euudiay/electrolites/report/acknowledgements.tex

% \chapter{}
% \label{sec:acknowledgements}
	
	% Los agradecimientos que vayamos a hacer
	\cleardoublepage
	\null\vspace{\stretch{1}}
	\begin{flushright}
		\emph{To Carlos, for his mad soldering skills and wise guidance,\\
		to Fran because of his healthy support,\\
		and very special thanks to everyone that has been there,\\
		bearing with us.}
	\end{flushright}
	\vspace{\stretch{3}}\null
