euudiay/electrolites/report/cover.tex

\thispagestyle{empty}

\begin{center}
	{\LARGE \textbf{\thetitle}}\\
	\vspace{0.5cm}
	% {\LARGE Sistema de monitorización ECG de bajo consumo para dispositivos móviles}\\
	{\Large Sistema inalámbrico de bajo consumo para monitorización de electrocardiogramas desde dispositivos Android}

	\vspace{1cm}
	{\large
		Pablo Fernández Vicente\\
		Rafael Basilio de la Hoz Sevilla\\
		\vspace{1.5mm}
		\hspace{1mm}Miguel Márquez Altuna
	}

	\vspace{1cm}
	% PROYECTO DE SISTEMAS INFORMÁTICOS\\
	% FACULTAD DE INFORMÁTICA\\
	Proyecto de Sistemas Informáticos, 
	Facultad de Informática\\
	Universidad Complutense de Madrid
	\vspace{1cm}

	\\
	\vspace{.5cm}
	% Department of Computer Architecture and Automation\\
	Departamento de Arquitectura de Computadores y Automática\\
	Curso 2011/2012
\end{center}

\begin{flushright}
	Directores:\\
	Luis Piñuel Moreno\\
	Joaquín Recas Piorno\\
\end{flushright}
