euudiay/electrolites/report/figs/mlts-arch-usb.pdf

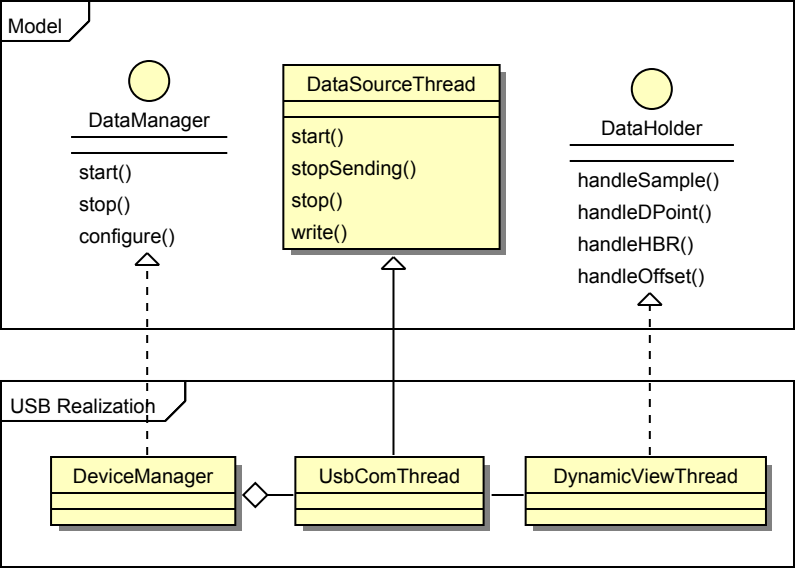
[picture p5: figure]
USBCRealization; Model; DataManager; start() stop() configure(); DataHolder; handleSample() handleDPoint() handleHBR() handleOffset(); DeviceManager; UsbComThread; DataSourceThread; start() stopSending() stop() write(); DynamicViewThread
