euudiay/electrolites/report/bibliography.tex

\begin{thebibliography}{widest-label}

\bibitem{ESL}
 	\emph{Real-Time Wavelet-Based Electrocardiogram Delineation System with Automatic Arrhythmia Detection}\\
 	Embedded Systems Laboratory, ESL\\
 	École Polytechnique Fédérale de Lausanne, EPFL\\
 	\url{http://esl.epfl.ch/cms/lang/en/pid/46016}\\
	
\bibitem{androidSpread}
	\emph{Google’s Android becomes the world’s leading smart phone platform}\\
	Canalys\\
	January 31, 2011\\
	\url{http://www.canalys.com/static/press_release/2011/r2011013.pdf}

\bibitem{sphoneStudy}
	\emph{The all-conquering smartphone seems headed for ubiquity}\\
	Gizmag\\
	September 5, 2011\\
	\url{http://www.gizmag.com/smartphone-sales/19723/}
	
\bibitem{andDev-what}
	\emph{What is Android}\\
	Android Developers\\
	\url{http://developer.android.com/guide/basics/what-is-android.html}

\bibitem{andDev-sdk}
	\emph{Android SDK}\\
	Android Developers\\
	\url{http://developer.android.com/sdk/index.html}
	
\bibitem{iosDev}
	\emph{Program Enrollment}\\
	iOS Developer Program\\
	\url{https://developer.apple.com/support/ios/enrollment.html#systemrequirements}
	
\bibitem{ecg.del.paper}
	\emph{Development and Evaluation of Multilead Wavelet-Based ECG Delineation Algorithms for Embedded Wireless
		Sensor Nodes}\\
	F. Rincón, J. Recas, N. Khaled, D. Atienza\\
	IEEE Transactions On Information Technology In Biomedicine, Vol. 15, No. 6, p. 854-863\\
	November, 2011
	
\bibitem{and-zigbee}
	\emph{Android ZigBee Interface}\\
	Texas Instruments\\
	\url{http://processors.wiki.ti.com/index.php/Android_ZigBee_Interface}
	
\bibitem{who-cvd}
	\emph{Cardiovascular diseases (CVDs)}\\
	World Health Organization\\
	\url{http://www.who.int/mediacentre/factsheets/fs317/en/index.html}
	
\bibitem{AppleJB}
	\emph{Unauthorized modification of iOS as a major source of instability, disruption of services, and other issues}\\
	Apple Support\\
	September 27, 2010\\
	\url{http://support.apple.com/kb/ht3743}
	
\bibitem{802.15.4}
	\emph{IEEE Std 802.15.4\texttrademark-2006}\\
	(Revision of IEEE Std 802.15.4-2003)\\
	Institute of Electrical and Electronics Engineers\\
	June 7, 2006
	
\bibitem{ADK}
	\emph{Android Open Accessory Development Kit}\\
	Android Developers\\
	\url{http://developer.android.com/guide/topics/usb/adk.html}
	
\bibitem{GoogleIO}
	\emph{Android Open Accessory API and Development Kit (ADK)}\\
	Mike Lockwood, Erik Gilling \& Jeff Brown\\
	May 10, 2011\\
	\url{http://www.google.com/events/io/2011/sessions/android-open-accessory-api-and-development-kit-adk.html}
	
\bibitem{dongle}
	\emph{IEEE 802.15.4/ZigBee\texttrademark USB Dongle}\\
	Integration, Adaptive Modules\\
	\url{http://www.adaptivemodules.com/assets/File/integration_802-15-4_usb\%20dongle.pdf}	

\bibitem{articleTI}
	\emph{TI presents World’s first platform bringing ZigBee to Android smartphones and tablets}.\\
 	Texas Instruments\\
	March 04, 2011\\
 	\url{http://www.ti.com/ww/in/news_detail/2011/news_detail_20110304.html}\\
 	
\bibitem{mbed}
	\emph{mbed: Rapid Prototyping with Microcontrollers}\\
	ARM Holdings\\
	\url{http://mbed.org/}
	
\bibitem{msp430}
	\emph{TI MSP430. Getting started}\\
	Texas Instruments\\
	\url{http://www.ti.com/lsds/ti/microcontroller/16-bit_msp430/getting_started.page}
	
\bibitem{msp430iss}
	\emph{MSP430 Family Instruction Set Summary}\\
	Texas Instruments\\
	\url{http://www.ti.com/sc/docs/products/micro/msp430/userguid/as_5.pdf}
	
\bibitem{5438a}
	\emph{MSP430F543xA, MSP430F541xA Mixed Signal Microcontroller Datasheet}\\
	Texas Instruments\\
	\url{http://www.ti.com/lit/ds/symlink/msp430f5438a.pdf}
	
\bibitem{msp430f6638ds}
	\emph{MSP430F663x Family Mixed Signal Microcontroller Datasheet}\\
	Texas Instruments\\
	\url{http://www.ti.com/lit/ds/symlink/msp430f6638.pdf}

\bibitem{5438aboard}
	\emph{MSP - EXP430F5438}\\
	Texas Instruments\\
	\url{http://www.ti.com/tool/msp-exp430f5438}

\bibitem{6638board}
	\emph{MSP - TS430PZ100USB}\\
	Texas Instruments\\
	\url{http://www.ti.com/tool/msp-ts430pz100usb}

\bibitem{Shimmer}
	\emph{Shimmer Platform - Key Features}\\
	Shimmer Research\\
	\url{http://www.shimmer-research.com/r-d/platform-features}

\bibitem{ShimmerExp}
	\emph{Shimmer Expansion Modules}\\
	Shimmer Research\\
	\url{http://www.shimmer-research.com/r-d/hardware/extension-modules}

\bibitem{usbhost}
	\emph{USB Host and Accessory}\\
	Android Developers\\
	\url{http://developer.android.com/guide/topics/usb/index.html}
	
\bibitem{TIUSB}
	\emph{MSP430 USB Developers Package}\\
	Texas Instruments\\
	\url{http://www.ti.com/tool/msp430usbdevpack}
	
\bibitem{xoomspecs}
	\emph{Motorola XOOM™ Fact Sheet}\\
	Motorola\\
	\url{http://mediacenter.motorola.com/Fact-Sheets/Motorola-XOOM-Fact-Sheet-3537.aspx}

\bibitem{andev-activity}
	\emph{Activities}\\
	Android Developers\\
	\url{http://developer.android.com/guide/topics/fundamentals/activities.html}
	
\bibitem{andev-view}
	\emph{View}\\
	Android Developers\\
	\url{http://developer.android.com/reference/android/view/View.html}

\bibitem{solarflight}
	\emph{Solar Impulse}\\
	\url{http://solarimpulse.com/}

\end{thebibliography}
