euudiay/electrolites/report/electrolites.tex

\documentclass[11pt,a4paper,openright]{book}
\usepackage{graphicx}
\usepackage[spanish, english]{babel}
\usepackage[utf8]{inputenc}
\usepackage[nottoc]{tocbibind}
\usepackage{appendix}
\usepackage[breaklinks,backref=true,colorlinks=true]{hyperref}
\usepackage{fancyhdr}
\usepackage{comment}
\usepackage{url}
\usepackage{todonotes}
\usepackage{wrapfig}
\usepackage{eurosans}
% \usepackage{layout}

\graphicspath{{figs/}}

\hyphenation{dis-po-si-ti-vo}
\hyphenation{dis-po-si-ti-vos}
\hyphenation{re-le-van-te}
\hyphenation{re-le-van-tes}

% Comandos para consultar la fecha y el título del documento
\newcommand{\thedate}{\today}
% \newcommand{\thetitle}{Electrolites}
\newcommand{\thetitle}{Low-power Wireless ECG Monitoring System for Android Devices}

\setlength{\parindent}{0in}

\title{\thetitle}
\author{Pablo Fernández\\Rafael de la Hoz\\Miguel Márquez}

\hypersetup{backref=true, colorlinks=true, linkcolor=black, menucolor=black,
	urlcolor=black, citecolor=black}

\linespread{1.125}

\begin{document}

	% \layout

	% \maketitle
	\frontmatter % Para prólogos y abstracts y cosas así (numeración romana)
	\pagestyle{fancy}

	% \listoftodos
	
	% Redefinición del estilo plain para cambiar los inicios de capítulos
	\fancypagestyle{plain} {
		\fancyhf{}
		\fancyfoot[RO,LE]{\thepage}
		\renewcommand{\headrulewidth}{0.0pt}
		\renewcommand{\footrulewidth}{0.0pt}
	}

	% Sin encabezados ni pie de página, sólo la numeración de la página
	\pagestyle{plain}
	\fancyhf{}
	\fancyfoot[RO,LE]{\thepage}
	\renewcommand{\headrulewidth}{0.0pt}
	\renewcommand{\footrulewidth}{0.0pt}

	% Documentos anteriores al índice
	\input{cover}
	\input{abstract}
	\input{acknowledgements}

	\tableofcontents % Índice

	% Para la lista de figuras y la de tablas, lo mismo
	\pagestyle{plain}
	\fancyhf{}
	\fancyfoot[RO,LE]{\thepage}
	\renewcommand{\headrulewidth}{0.0pt}
	\renewcommand{\footrulewidth}{0.0pt}
	\listoffigures
	% \listoftables

	\input{spanish}

	% formato para encabezado/pie de pagina para el resto del documento
	\mainmatter % Para el resto del documento (numeración arábiga)
	\pagestyle{fancy}
	\renewcommand{\chaptermark}[1]{\markboth{#1}{}}	% Para que no nos lo escriba en mayúsculas
	\renewcommand{\sectionmark}[1]{\markright{#1}{}}	% Para que no nos lo escriba en mayúsculas
	\fancyfoot[RO,LE]{\thepage}					% Número de página en los bordes
	\fancyfoot[RE,LO]{{\it \thetitle}}				% Título del documento en el interior del pie de página
	\fancyhead[LE]{{\it \leftmark}}				% Sección (izquierda, pares)
	\fancyhead[RO]{{\it \rightmark}}				% Capítulo (derecha, impares)
	\fancyhead[RE]{}							% (derecha, pares)
	\fancyhead[LO]{}							% (izquierda, impares)
	\cfoot{}
	\renewcommand{\headrulewidth}{1.1pt}			% Grosor de la línea del encabezado
	\renewcommand{\footrulewidth}{1.1pt}			% Grosor de la línea del pie de página

	% Capítulos
	\input{intro}
	\input{hardware}
	\input{software}
	\input{results}

	% Anexos
	\begin{appendices}
		\renewcommand{\setthesection}{\Alph{section}}	% Numeramos con letras
		\appendix
		\appendixpage
		\input{engineering}
	\end{appendices}

	% Bibliografía
	\fancyhf{}
	\fancyfoot[RO,LE]{\thepage}
	\renewcommand{\headrulewidth}{0.0pt}
	\renewcommand{\footrulewidth}{0.0pt}
	\input{bibliography}

\end{document}
