euudiay/electrolites/report/figs/mlts-arch-bt.pdf

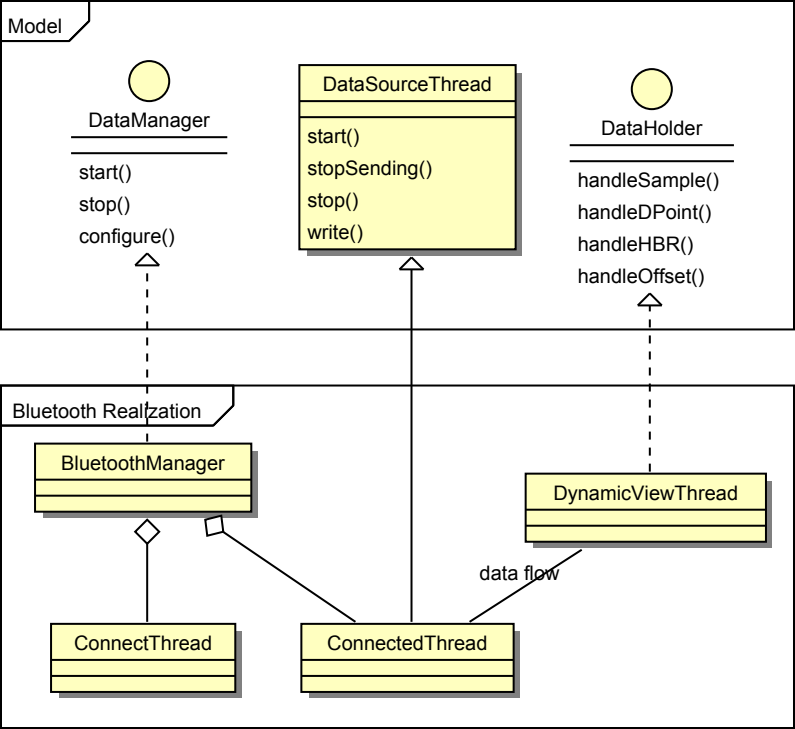
[picture p19: figure]
BluetoothwRealization; Model; ConnectThread; DataHolder; handleSample() handleDPoint() handleHBR() handleOffset(); ConnectedThread; DataSourceThread; start() stopSending() stop() write(); BluetoothManager; DataManager; start() stop() configure(); DynamicViewThread; datawflow
