euudiay/electrolites/report/figs/mlts-arch-log.pdf

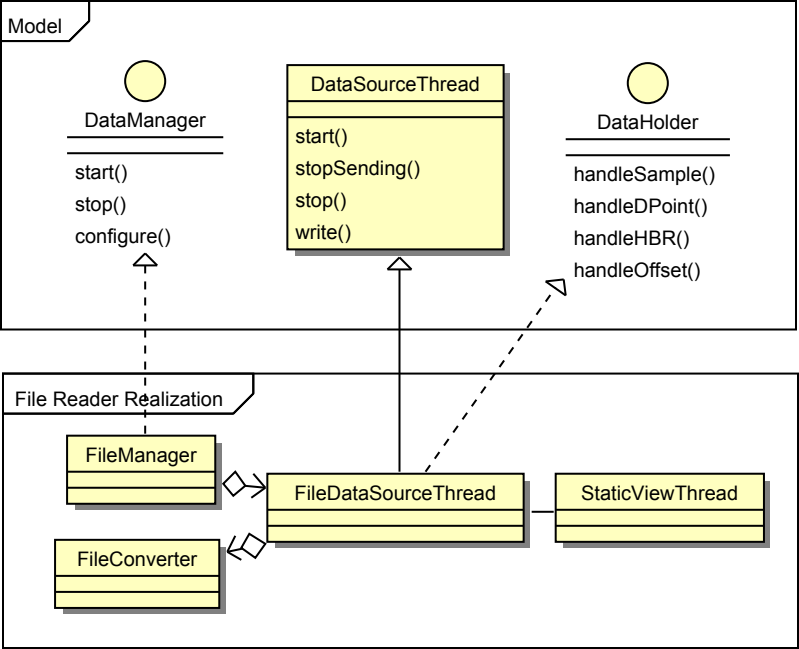
[picture p20: figure]
FilefReaderfRealization; Model; DataSourceThread; start() stopSending() stop() write(); DataHolder; handleSample() handleDPoint() handleHBR() handleOffset(); DataManager; start() stop() configure(); FileDataSourceThread; StaticViewThread; FileConverter; FileManager
