euudiay/electrolites/report/figs/mlts-arch-main.pdf

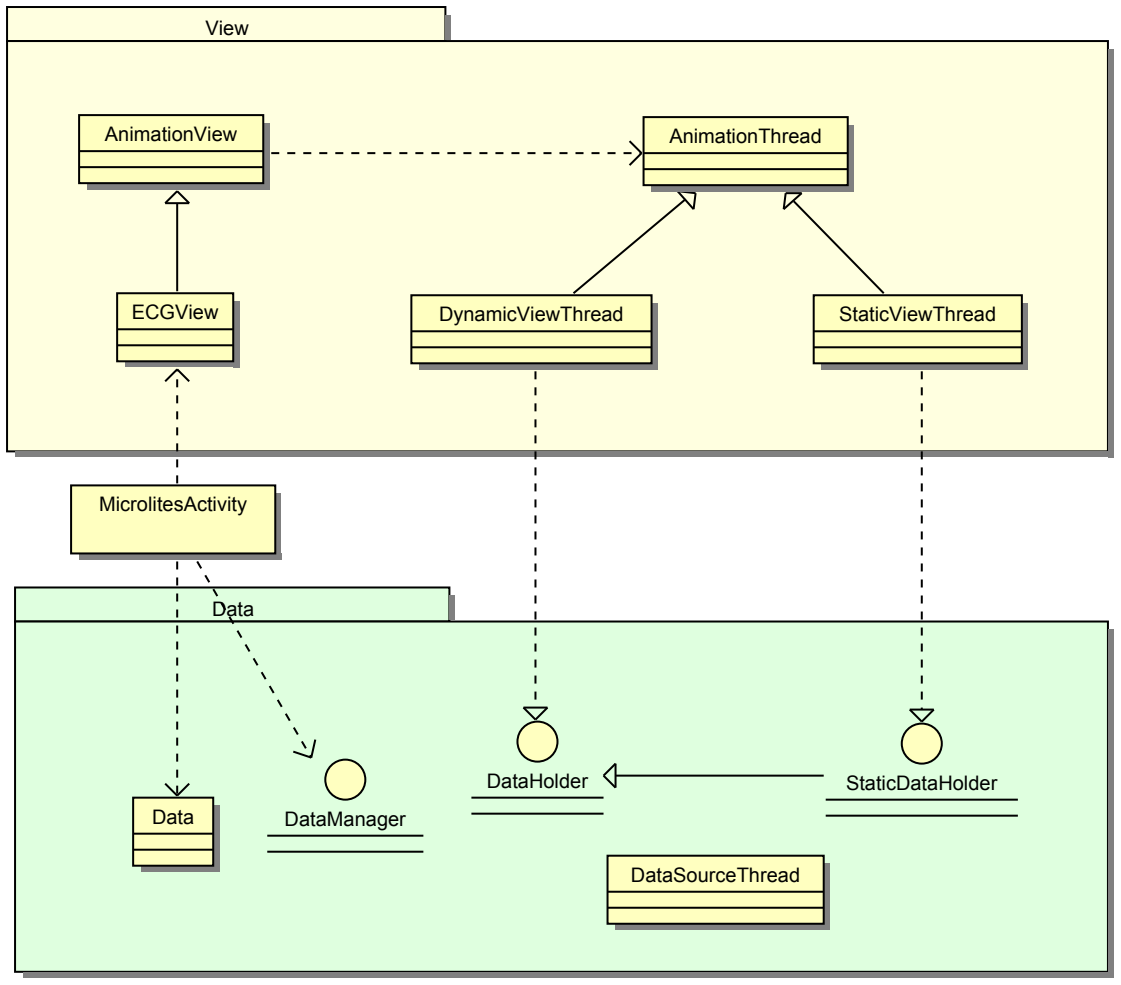
[picture p21: figure]
View; Data; DataSourceThread; StaticDataHolder; MicrolitesActivity; ECGView; AnimationView; AnimationThread; DynamicViewThread; StaticViewThread; DataHolder; DataManager

Bluetooth | Filereader | USB
