euudiay/electrolites/report/figs/mlts-arch-model.pdf

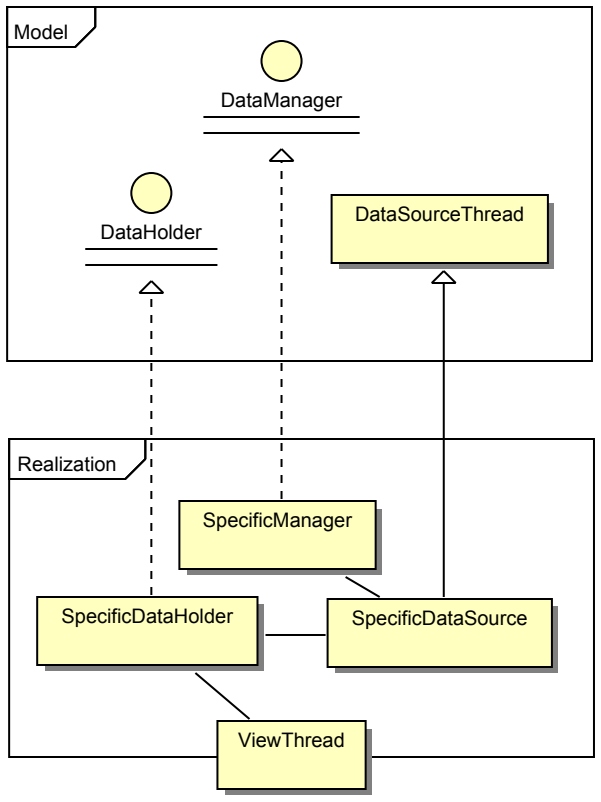
[picture p22: figure]
Model; Realization; DataManager; ViewThread; DataSourceThread; DataHolder; SpecificManager; SpecificDataHolder; SpecificDataSource
