euudiay/electrolites/report/figs/PCB-3D-Print.pdf

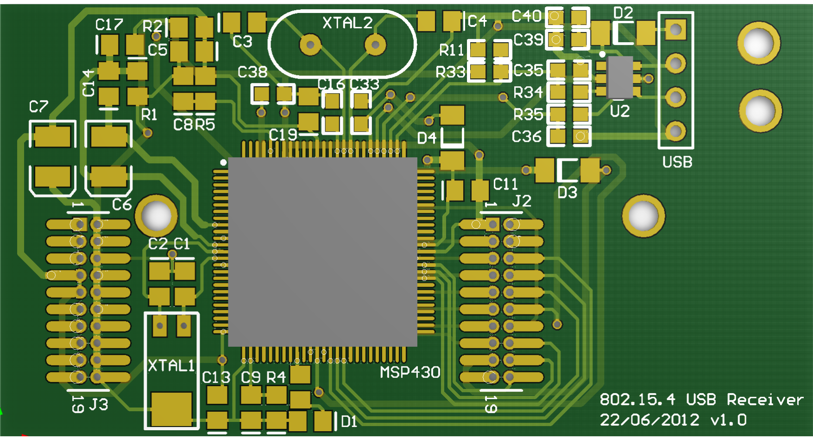
[picture p23: page 1]
