euudiay/electrolites/report/figs/pcb-a.pdf

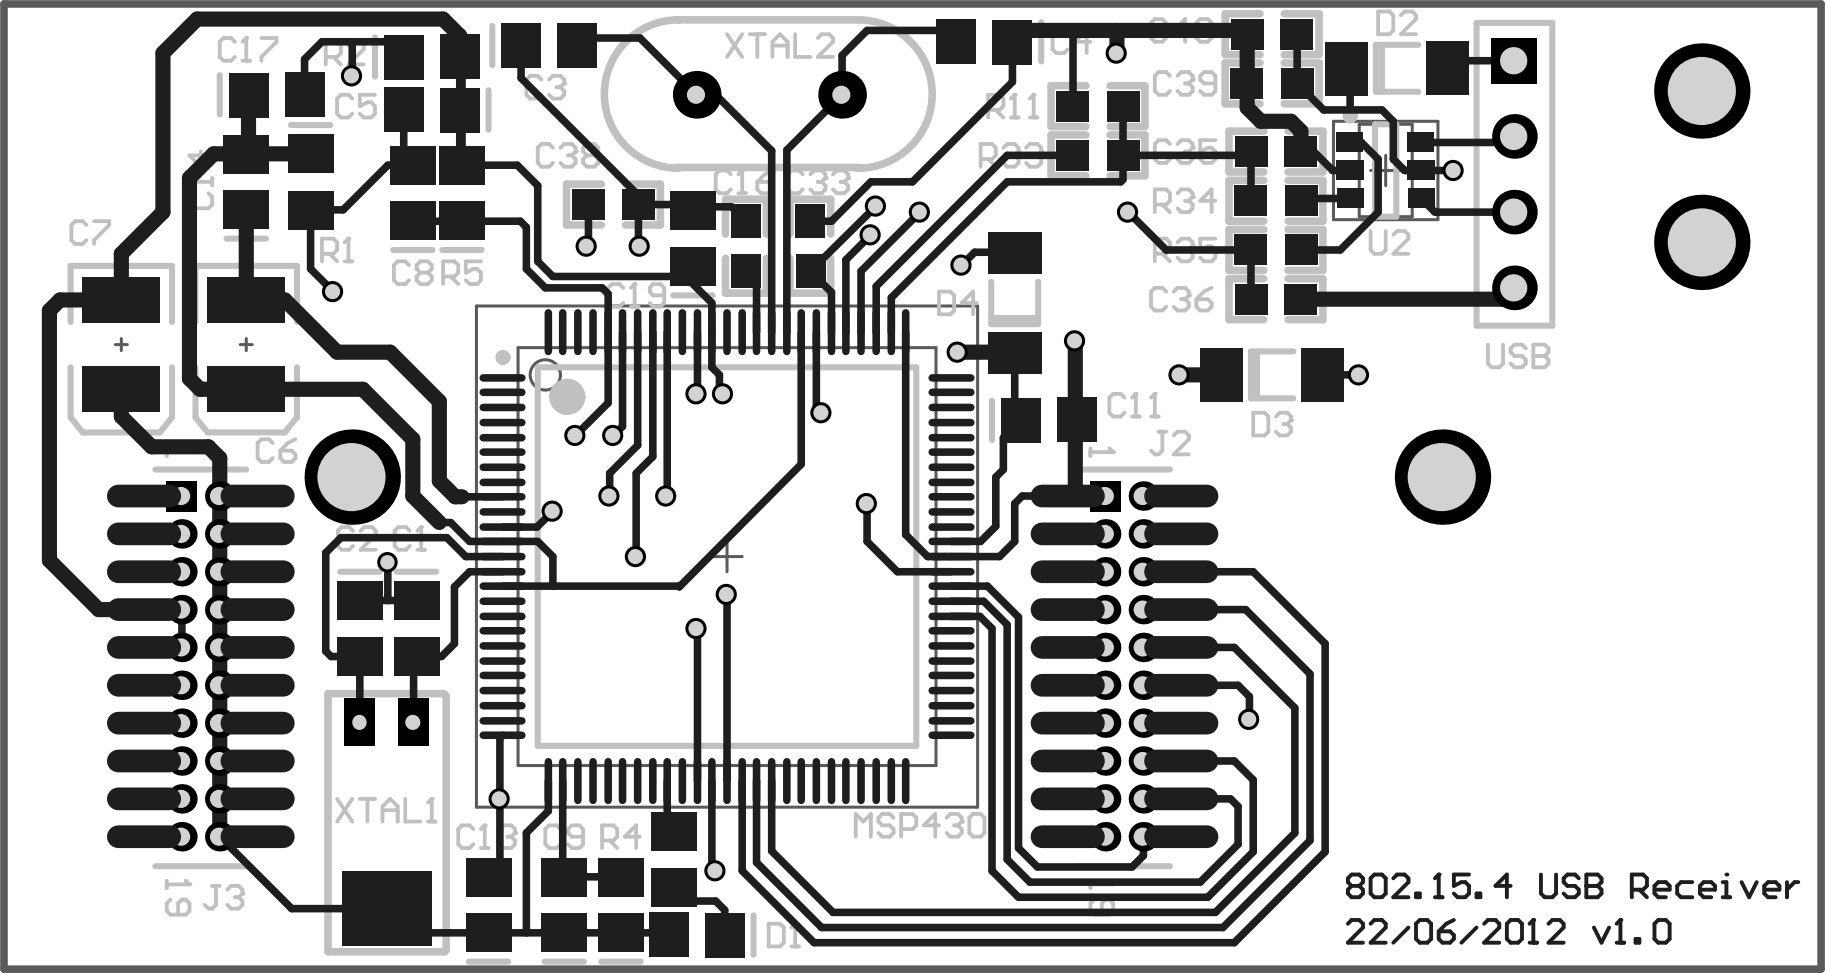
[picture p24: page 1]
