euudiay/electrolites/report/figs/pcb-b.pdf

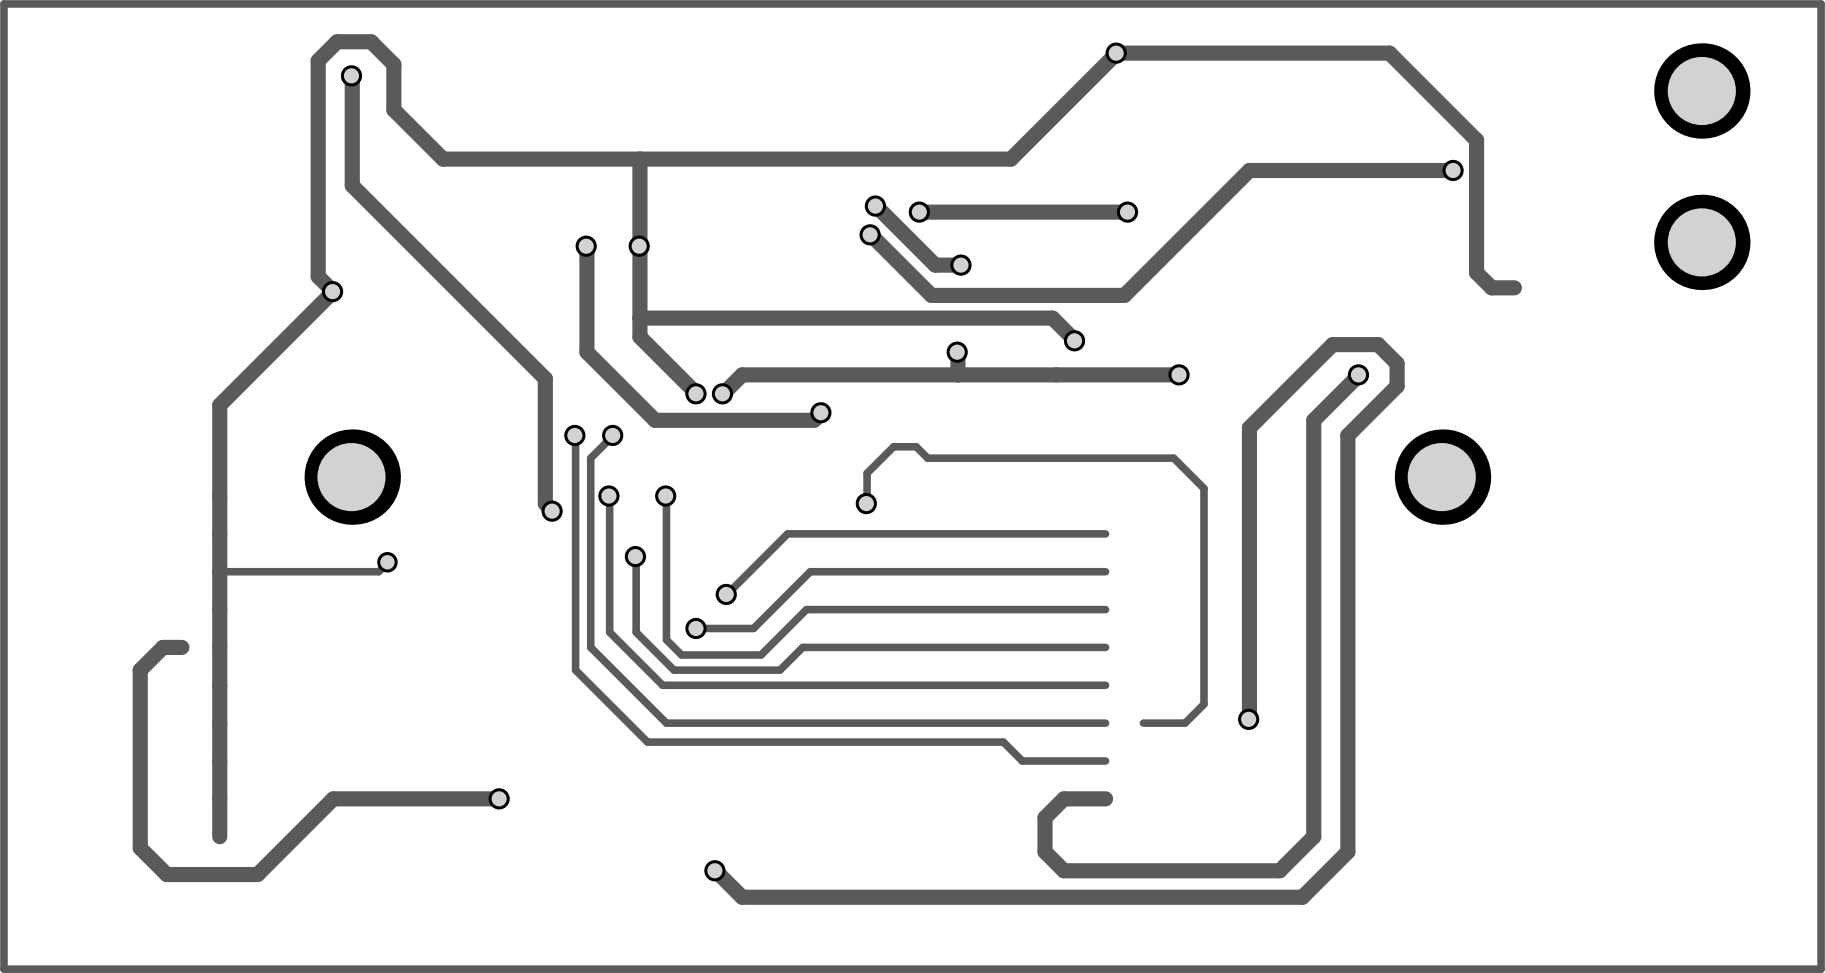
[picture p25: page 1]
