euudiay/electrolites/report/figs/schematic.pdf

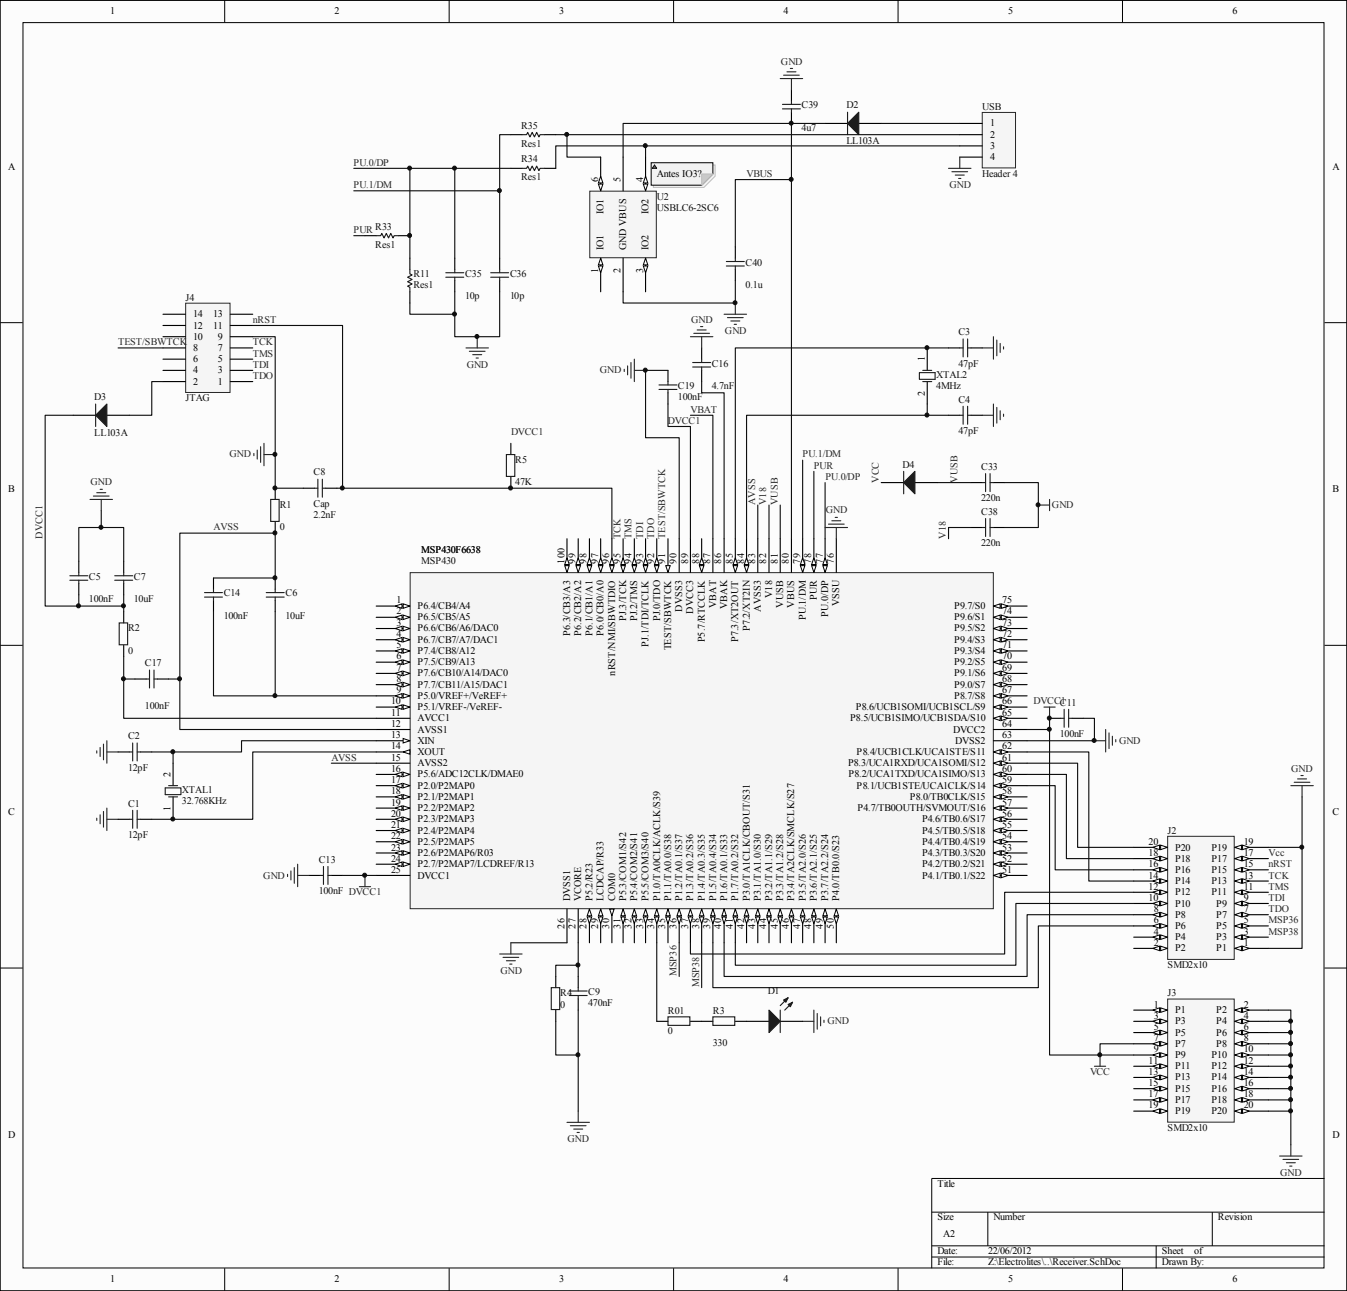
[picture p26: page 1]

76 PU.0/DP 77 PUR 78 PU.1/DM 79 VBUS 80 VUSB 81 V18 82 AVSS3 83 P7.2/XT2IN 84 P7.3/XT2OUT 85 VBAK 86 VBAT 87 P5.7/RTCCLK 88 DVCC3 89 DVSS3 90 TEST/SBWTCK 91 PJ.0/TDO 92 PJ.1/TDI/TCLK 93 PJ.2/TMS 94 PJ.3/TCK 95 nRST/NMI/SBWTDIO 96 P6.0/CB0/A0 97 P6.1/CB1/A1 98 P6.2/CB2/A2 99 P6.3/CB3/A3
