euudiay/electrolites/report/figs/Final-Artwork-Prints1.pdf

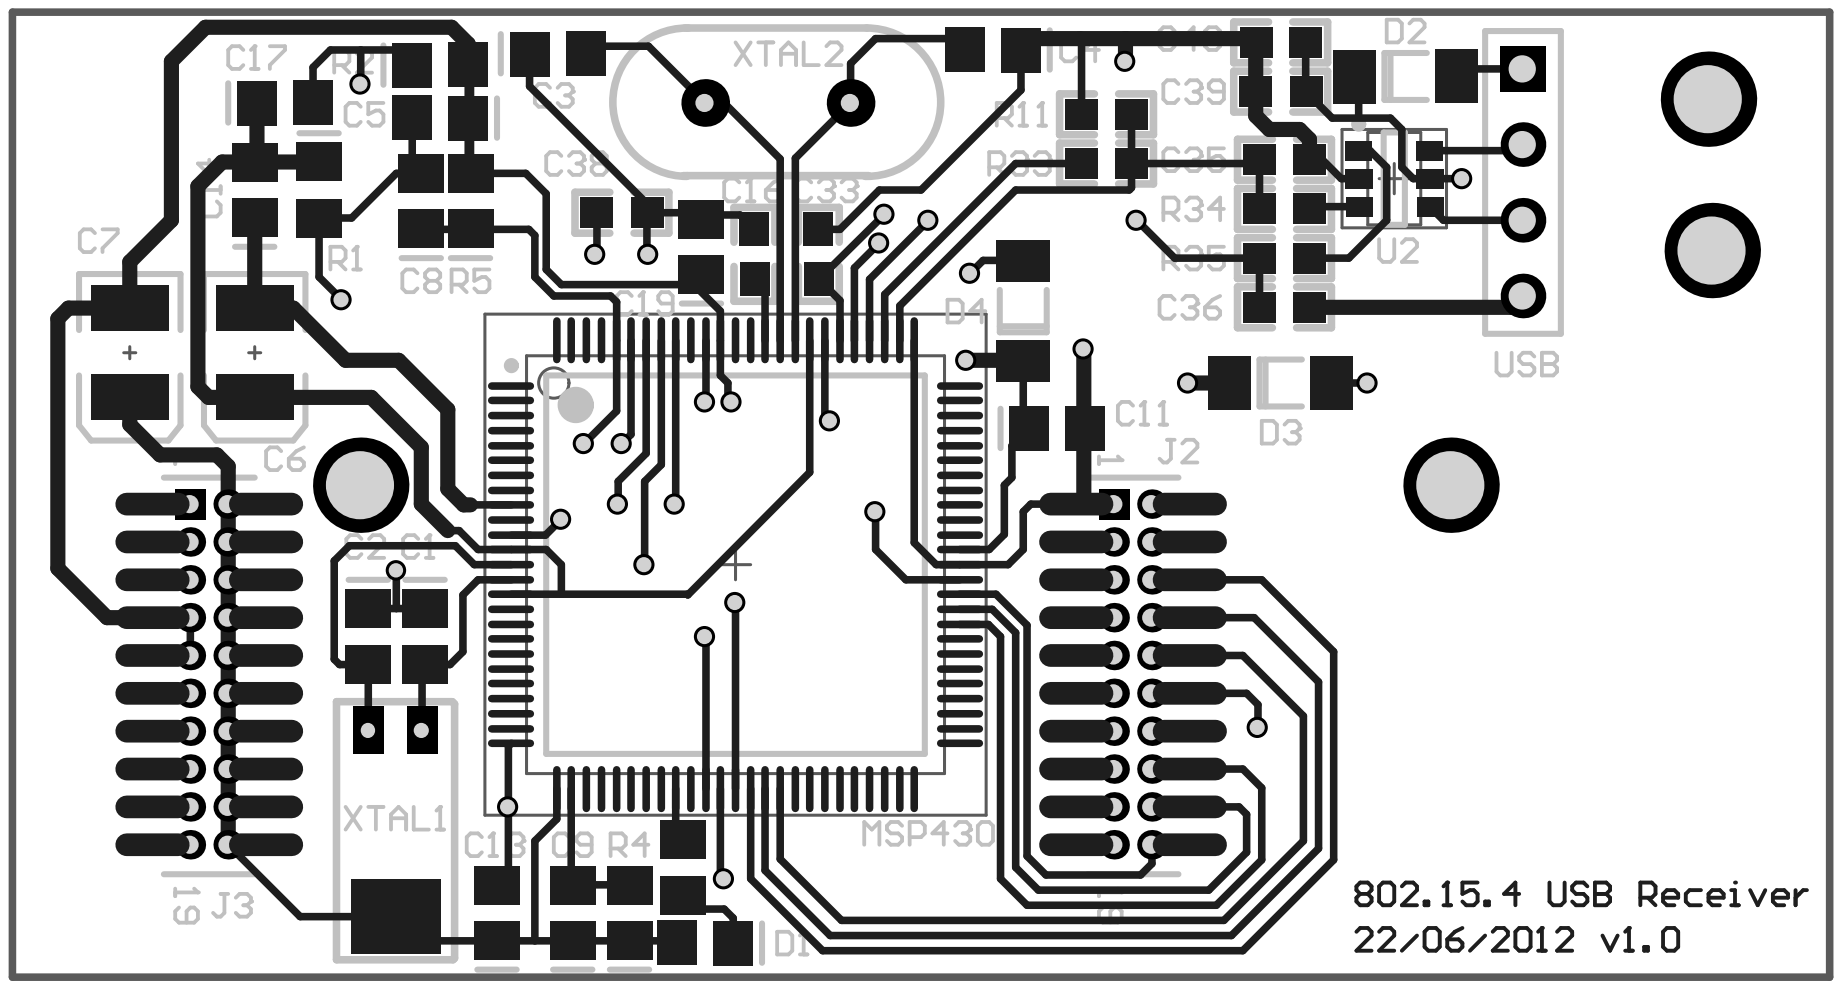
[picture p27: page 1]
