euudiay/electrolites/report/figs/Final-Artwork-Prints2.pdf

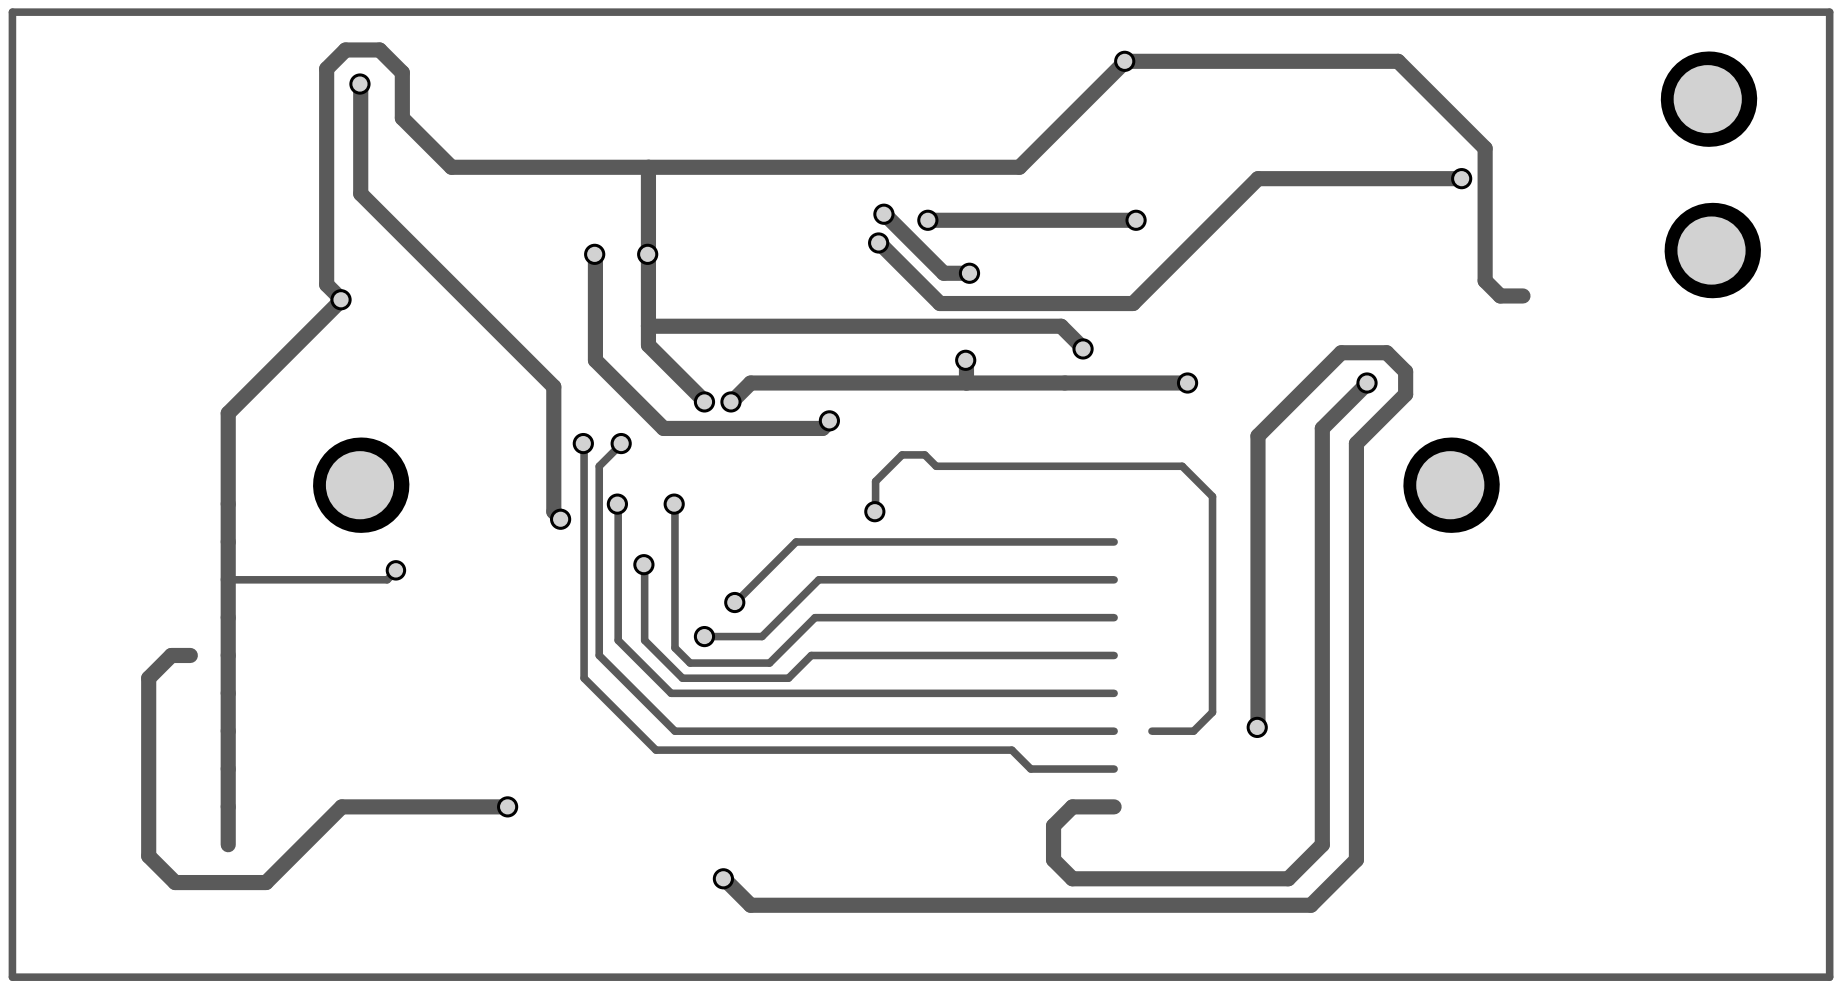
[picture p28: page 1]
