euudiay/electrolites/report/figs/gantt-r.pdf

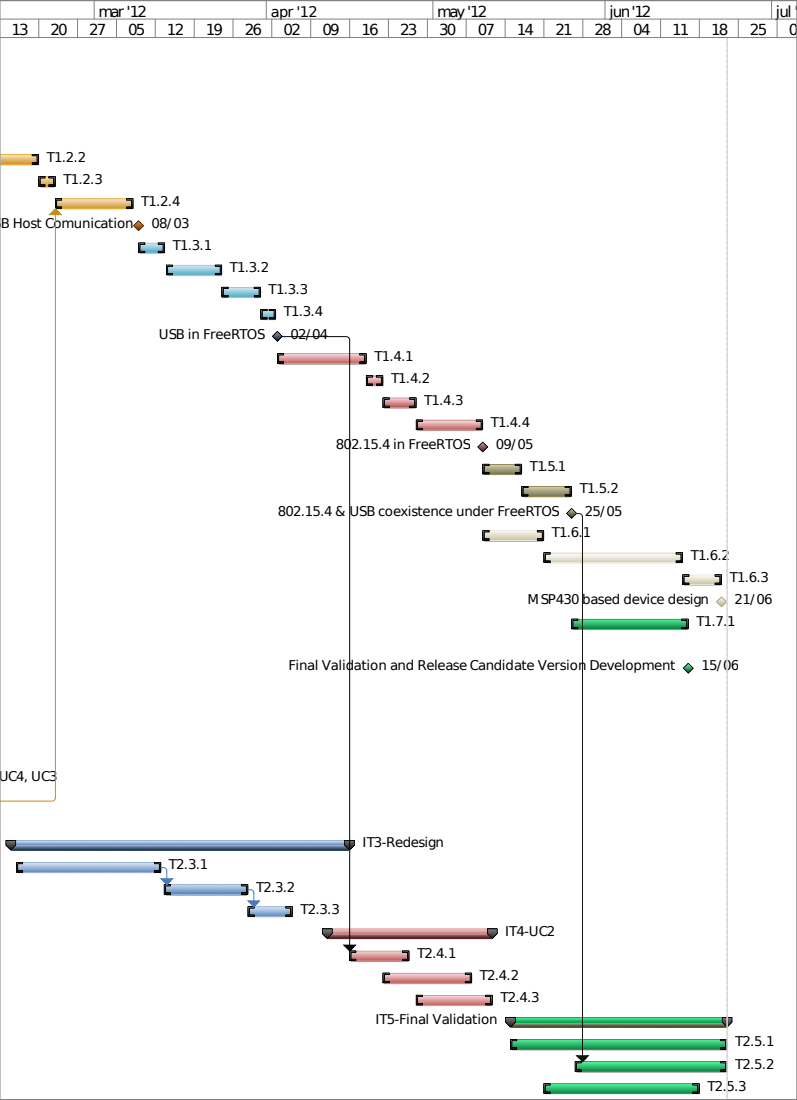
[picture p29: page 1]
mar '12; apr '12; may '12
