euudiay/electrolites/report/figs/gantt-l.pdf

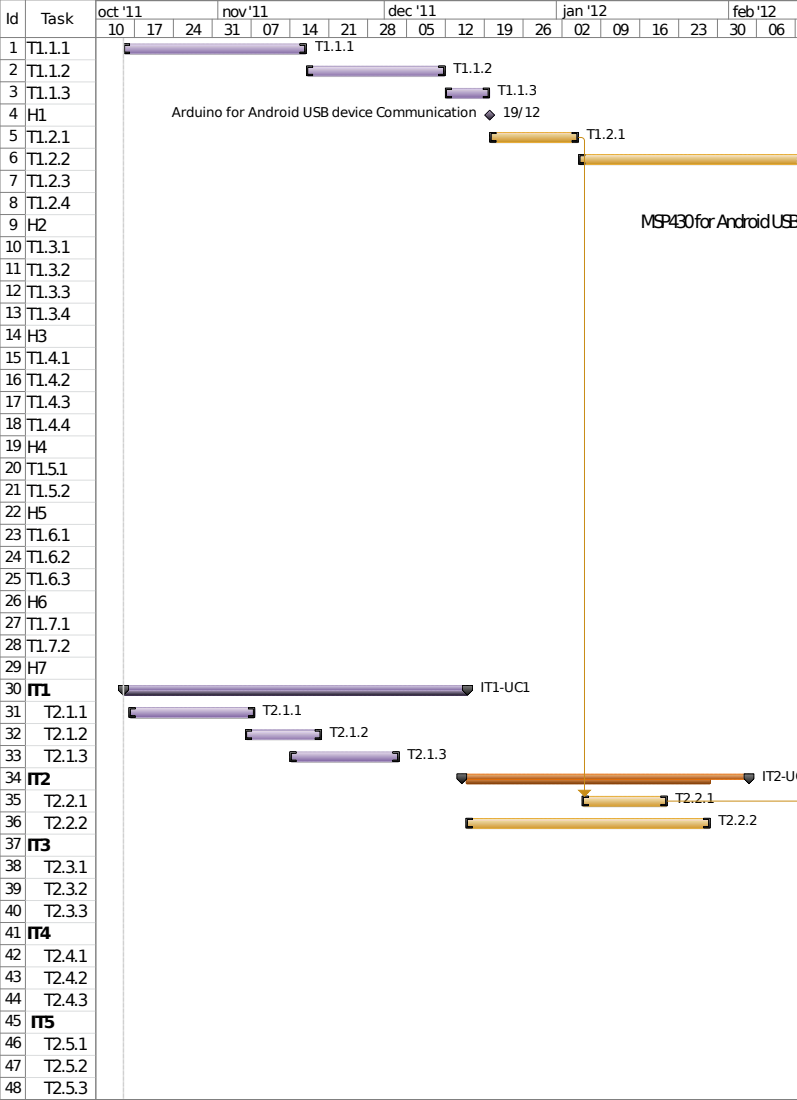
[picture p30: page 1]
oct '11; nov '11; dec '11; jan '12; feb '12
