euudiay/electrolites/report/figs/chartLeft.pdf

1 | T1.1.1 2 | T1.1.2 3 | T1.1.3 4 | H1 5 | T1.2.1 6 | T1.2.2 7 | T1.2.3 8 | T1.2.4 9 | H2

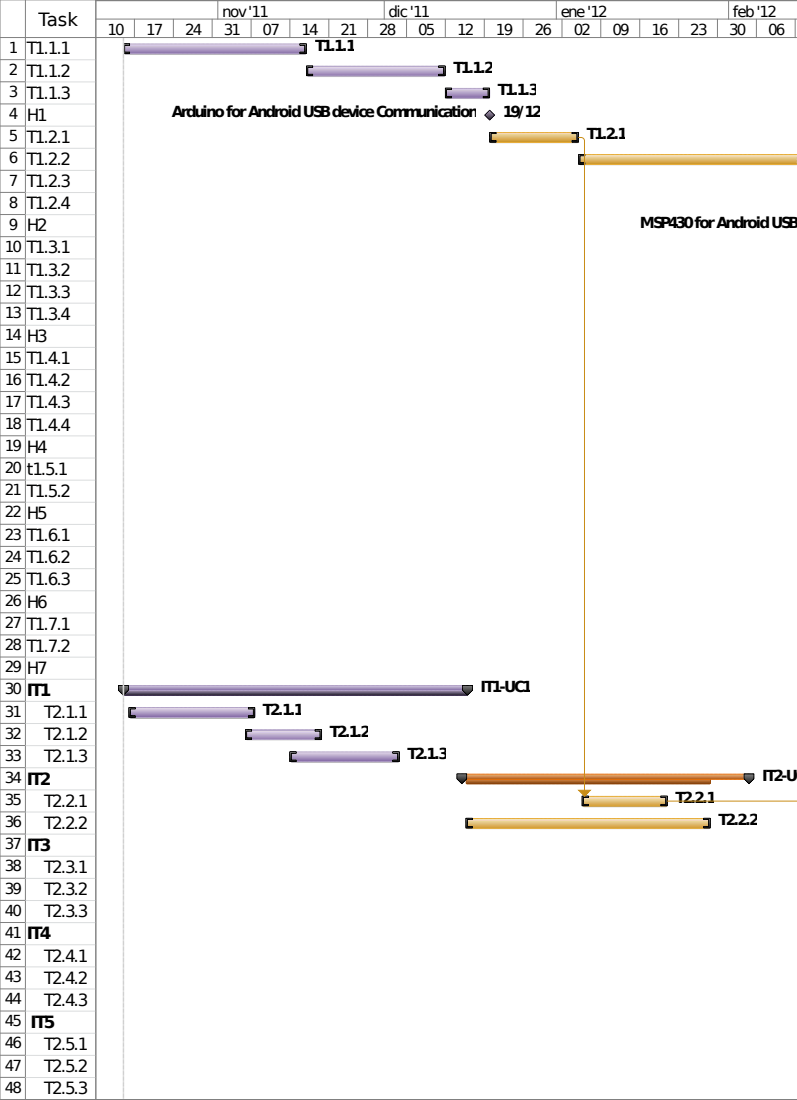
[picture p31: page 1]
nov '11; dic '11; ene '12; feb '12
