euudiay/electrolites/report/figs/chartRight.pdf

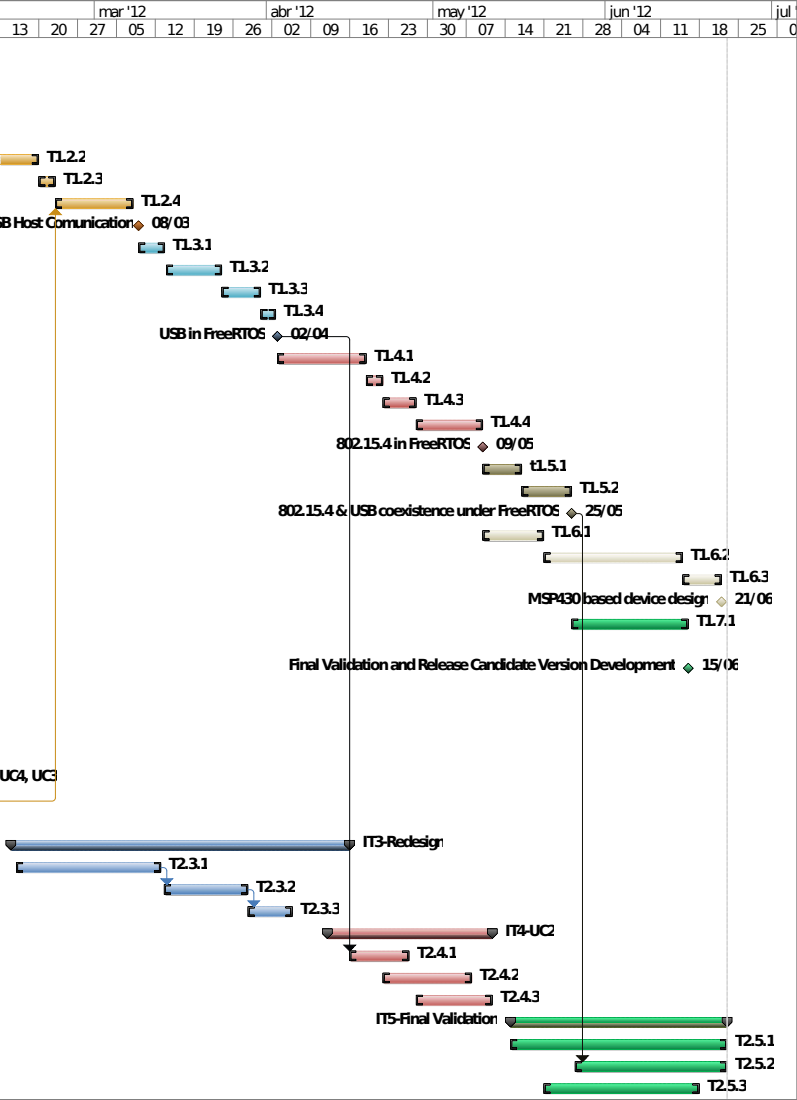
[picture p32: page 1]
mar '12; abr '12; may '12
