euudiay/electrolites/report/figs/ucm.pdf

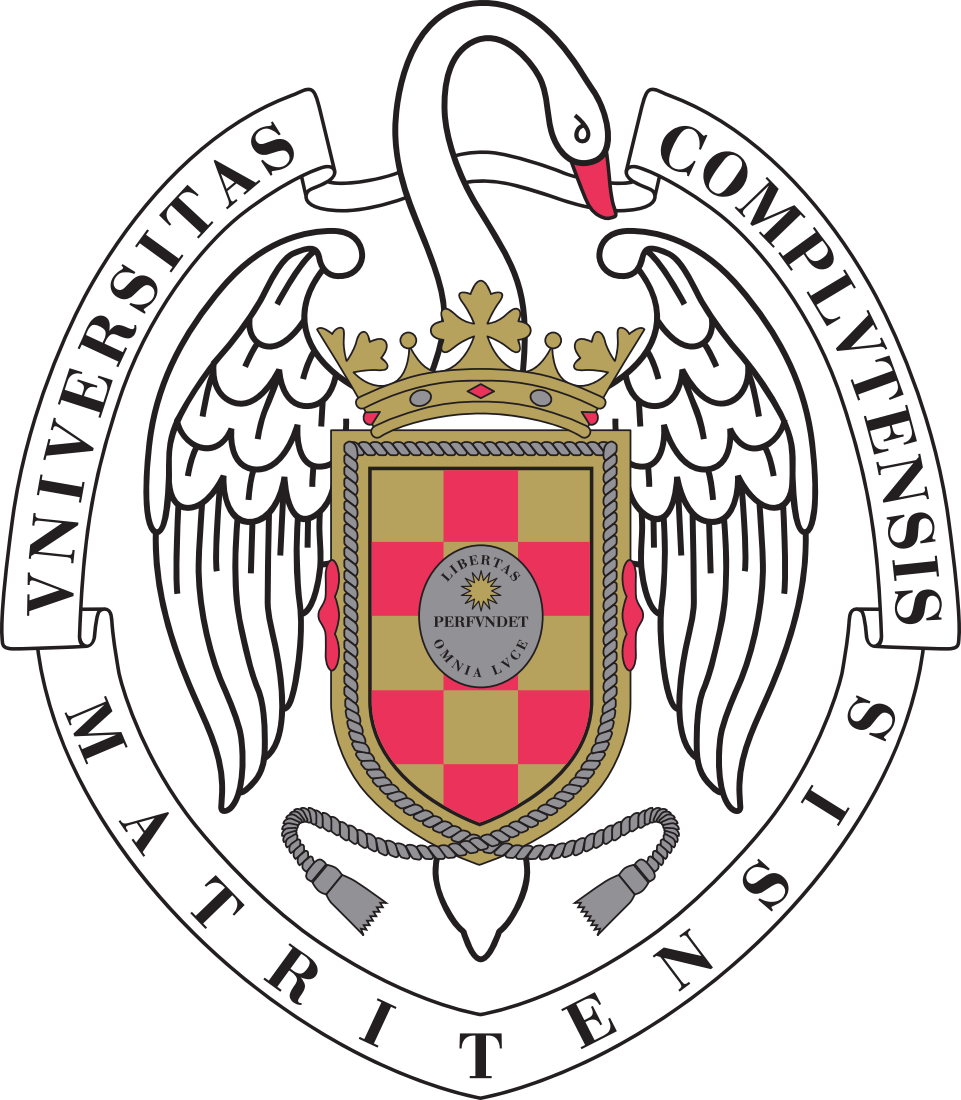
[picture p33: page 1]
