euudiay/electrolites/(list of files, drawings)

Other design files:
pcb/PCBReceiverProject/MELF - Diode.PcbLib
pcb/PCBReceiverProject/PCBReceiverProject.PrjPCB
pcb/PCBReceiverProject/Receiver.PcbDoc
pcb/PCBReceiverProject/Receiver.PcbLib
pcb/PCBReceiverProject/Receiver.SchDoc
pcb/PCBReceiverProject/Receiver.SCHLIB
pcb/PCBReceiverProject/Reciver.SchDoc
