euudiay/electrolites/(commit log)

2011-10-13 Project structure created.
    [proguard.cfg]
2011-10-14 Actualizado el package.
2011-10-14 Generalizado método de dibujo de ecgs. Añadida clase auxiliar Point.
2011-10-14 Cosas con botones que no funcionan (pero antes sí que lo hacían)
2011-10-15 - Eliminado el FC - Cosas con OnClickListener
2011-10-16 - He hecho AnimationView y AnimationThread abstractas, para que podamos heredar de ellas y reaprovechar Views con control de fps que nos gusta tanto (es una idea que se me ha ocurrido, no sé si os gu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
2011-10-19 - Creado FileConverter, que lee y convierte archivos con muestras de txt a binario y viceversa (además de guardar los bytes en un ArrayList con el que no se hace nada). - Añadido el archivo "traza.tx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
    Por cierto, cuidado con que Java no tiene tipos unsigned (byte, por ejemplo, va de -127 a 127), así que para que sacar el unsigned hay que hacer el típico "& 0xff"
2011-10-19 Primera versión de clase auxiliar Viewport para asisitir en el renderizado de puntos.
2011-10-20 - Añadida primera versión de la clase DataParser - Añadida clase auxiliar Sample.
2011-10-22 +Tortoise debe estar enfafado conmigo porque me dice que la carpeta com está bloqueada o no se que mierdas así que tengo que hacer el commit en dos mitades.
2011-10-22 + La interfaz está casi terminada con el diseño inicial, nada hace nada aún pero ya se dibuja todo en su sitio(o casi).
2011-10-22 Subo lo que modifiqué de mis clases (a medias, pero compila), para poder hacer un checkout limpio, que me está dando problemas.
2011-10-23 + Implementado visualizador estático con sistema de cámara básico y parámetros mínimos. + Implementado sistema de scrolling (hiper básico) para recorrer el archivo + Comentada cosa del main.xml porqu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
2011-10-25 - Iconos - Scroll inverso (en realidad directo) - Hay que darle a start para empezar
2011-10-25 - Ya sabemos leer desde 'res' (que parecía fácil, pero lo mío me ha costado). - Ya se interpretan las muestras (o, al menos, eso parece, habrá que ajustar límites y tal). - Me daba un problema el señ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
2011-10-26 - Eliminada la clase Sample, que ya no hacía falta. - Añadida la clase DPoint, con info sobre los puntos de la delineación. - Definidos unas estructuras de datos (todavía prematuras, supongo) en Data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
2011-10-27 +Añadida la funcionalidad de subir y bajar la barra, y cambiado el layout con nombres representativos
2011-10-27 +Ya funcionan + y -, han recuperado su orden natural en el espacio, el teclado ya no sale solo y la pantalla se puede girar sin que explote, ya no pone "Aqui van cosas" y down se escribe en una sola 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
2011-10-27 - Modificados los tipos de datos de Data - Métodos de parsing terminados (primera versión) - Reorganizadas las clases DataParser y FileConverter, que estaban regular. - Ahora el resource 'traza' se c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
2011-10-28 Sincronizado el Viewthread con el modelo de Datos. Añadido offset al modelo de Datos. Implementado renderizado del resultado de la delineación. Nota: Fallan los colores al renderizar los picos QRS
2011-10-30 Mejorado el dibujo de las delineaciones. Arreglado el tema de los picos de QRS que salían mal. Apañado Viewport para trabajar con los datos reales de Data. Añadido eje vertical numerado. Embellecido 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
2011-10-30 + Añadidas cosas de verdad al menú: + Un boton que hace lo mismo que el de start de la aplicacion + Un boton de about que saca un dialogo hecho a mano y con mucho cariño por mi y que me ha costado mu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
2011-10-30 + Añadido un detallito de la visualización + Arreglado el fallo al re-abrir la aplicación una vez minimizada (para lo cual el displayview de la GUI está comentado, podéis descomentarlo pero dejará de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
2011-11-01 +Comiteo una chorradita, simplemente he sustituido el diplayview por un campo de texto que pone lo mismo y he cambiado el color de fondo al mismo y al de las pulsaciones para que no quede raro como q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
2011-11-04 Implementación básica de jerarquía de Services para obtención de datos. No plenamente funcional, los servicios deben meter los datos en Data directamente.
2011-11-05 + Implementado autoscroll, botón para activarlo/desactivarlo y forma de desactivarlo moviendo manualmente la ventana. + Implementado Servicio generador de datos aleatorios en tiempo real, arreglando 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
2011-11-09 +La carga de archivos está y además justo como quería(y espero que como queriamos tambien), si le das a load, lee el contenido de la carpeta de logs y te muestra unica y exclusivamente los archivos c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
2011-11-09 Commit de "por si acaso": - Creado el paquete "bluetooth", para guardar las clases de los threads que intervienen en la comunicación. - Añadido el esqueleto del BluetoothService. Todavía no hace nada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
    Más tarde o mañana termino la implementación de BluetoothService (en su mayor parte es refactorizar e implementar el comportamiento que queramos que tenga).
2011-11-09 - Incluido (aunque comentado) BluetoothService en el manifiesto. - Implementadas la constructora y el onStartRunning de BluetoothService. - Pequeños cambios, cambios que...
    Mañana sigo.
2011-11-11 Agregado hilo bluetooth sin mucho éxito aún. Reimplementado Viewport debido a lío con los dominios de las variables. Ahora todo va como la seda :D
2011-11-13 - Modificado el main del layout para que no salga culo la GUI cuando el tablet está en modo portrait. - Arreglada la altura de un par de botones que eran ligeramente más altos que los demás.
    Known issue: El campo de texto "Name" al principio es chiquitico y va creciendo según se va llenando. No he sabido hacerlo de otra forma para que la GUI salga bien.
2011-11-13 Lo que os contaba ayer más o menos, ahora puedo conectarme con otros moviles que tengan el chat bluetooth o que simplemente estén esperando a que les llegue otra conexión, pero con el shimmer sigo si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
2011-11-14 Al final no he hecho lo de que cuando le des a Load no siga recibiendo bluetooth porque no ha salido a la primera y no es momento de investigar.
    +Funciona, el bluetooth funciona
2011-11-15 - Muchos cambios, cambios que... - Ahora se ve por pantalla lo que manda el Shimmer :3 (un poco y a veces, pero se ve)
2011-11-17 - AcceptThread ya no nos hace falta, lo quitamos. - DataParser ya no está en el Service padre, si no en los hijos. - Las estructuras de datos de DataParser pasan a DataService (samples, dpoints y hbr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
2011-11-17 Eliminado botón de autoscroll. Comenzada refactorización de la vista, no funcional la dinámica aún. Planteado modo de operación de la aplicación, no funcional aún. Arreglada la distribución de editTe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
2011-11-18 Modificaciones menores al hilo de visualización y arreglado un fallo de acumulación de memoria en DataParser.
2011-11-18 Comenzada la implementación de la vista en tiempo real con su correspondiente apartado en Data.
2011-11-19 Implementada vistas en tiempo real y estática por separado, en hilos distintos y con datos distintos. Eliminado el overflow de memoria (al menos retrasado lo suficiente para no frustrarnos). Apañado 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
2011-11-22 Más modificaciones para que todo vaya mejor (mentira!)
2011-11-25 Arreglado cosa de dessincronización vista-producción, y muchas cosas más.
2011-11-25 Implementado parser en tiempo real que nos ha devuelto al estado anterior de la aplicación.
2011-11-27 Implementada visualización en tiempo real completa, incluyendo dpoints, hbrs y muestras. Falta pulir algunos detalles. La lista de cambios es lo suficientmente grande para que todos la obviemos.
2011-12-01 Implementado buffer extra de samples para que de tiempo a ver algo. Falta implementar que se cojan las últimas muestras en vez de las primeras.
2011-12-02 - Añadido paquete usb - Añadidas las clases AccessoryManager, que controla la conexión con un accesorio USB, y UsbComThread, que se encarga de la comunicación con el accesorio (todavía no hace nada, 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
2011-12-02 Implementada visualización de parte de lista de samples correcta. Añadidos muchos detalles de depuración. Actualmente no funciona debido al commit anterior.
2011-12-02 Reescrita la clase AccessoryManager que había machacado esta mañana. No ha sido demasiado horrible.
2011-12-04 Hackeo para sincronizar los dpoints. Algo de memoria ahorrada por ahí. Arreglados algunos fallos aquí y allí. Comenzado el guardado en logs.
2011-12-07 - Añadido algo de funcionalidad a UsbComThread. - Robustecido el stop de AccessoryManager (aunque sigue sin ser llamado). - Añadido "accessory_filter.xml" (o no, es posible que tenga que hacer otro c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
2011-12-07 Arreglado problema con el desregistro de servicios. Arreglado otro detalle de los intentServices. Comenzado el principio del fin de los problemas de visualización.
2011-12-11 +Arreglado el hecho de que se salieran de rango los indices de los offsets y los dPoints
    +Arreglado el guardado de la visualización en tiempo real
2011-12-13 Eliminada una línea de log que sobraba. Ahora los dpoints se vuelven a pintar hasta la altura de la muestra (yo me entiendo)
2011-12-15 Guardado de todo en el archivo de log Cambiado el nombre de una variable de dudosa reputación
2011-12-19 + Implementado hilo usb funcional :D + Aumentada la velocidad de este + Cambiado el botón de Random por el de USB y renombrado Start a Bluetooth (temporalmente).
2011-12-26 Muchos cambios, aunque no significan demasiado progreso: - Reescritas varias clases: DataParser, FileParserService y alguna más. - Actualizada un poco Data, la parte estática, pero sin reorganizar to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
    Todavía queda mucho curro, es un commit más que nada de "por si acaso".
2011-12-26 - Arreglado el commit anterior porque me salió mal mergear el conflict. - Formateado un poco main.xml para que se entienda algo.
2011-12-27 - Comenzada la reorganización de Data en DynamicData y StaticData. - El intent de Pferv ya no es de Pferv. - Clase DPoint movida -grandísima- al paquete utils. - Retoques varios.
2012-03-03 Implementada escritura de log raw de bytes sin parsear para correcta lectura por parte de StaticFriendlyDataParser.
2012-03-10 +Ya mandamos cosas por USB desde el MSP430 a electrolites
2012-03-15 +Algunos de los ultimos cambios del USB que por lo que veo estaban sin comitear
2012-03-25 +Comentada una cosa en Accesory manager para que funione el proyecto, esa clase ya no se usa, solo la mantengo por si la quisieramos para algo.
    +Por lo demás solo he añadido comentarios y quitado trozos de código comentado que no valian para nada, para que al traducirlo a microlites resulte más sencillo
2012-05-01 - Movido Electrolites de trunk a trunk/electrolites. - Añadido el esqueleto de la memoria, ya funcional, al menos en mi ordenador (en trunk/report).
    [proguard.cfg]
2012-05-01 - Movidos unos cuantos archivos ocultos de electrolites que se habían quedado fuera (da igual porque el código es antiguo, pero bueno).
2012-05-04 Rellenado microlites oh por dios funciona por favor funciona
    [proguard.cfg]
2012-05-04 Añadida carpeta res que soy idiota y la olvidé (wey) Añadido proyecto de diseño del pcb a trunk/pcb
    [MSP430F6638Lib.SCHLIB, PCBReceiverProject.PrjPCB, Receiver.SchDoc, Reciver.SchDoc, Sheet.SchDoc]
2012-05-04 Renombrados y modificados los pines del 1 al 25 del MSP430F6638.
    [MSP430F6638Lib.SCHLIB]
2012-05-05 - Cambiados pines del 26 al 50. - No subo el archivo .PrjPCB, que mi Altium prácticamente lo ha vaciado (si hace falta, el nuevo lo tengo yo, así que no pasa nada).
    [MSP430F6638Lib.SCHLIB]
2012-05-05 Validados pines 1~50 del msp430f6638 y preparados pines 51~100 Cambiado el msp430f5xxx por el 6638 en Receiver.SchDoc Eliminados dos zips que sobraban en las libs.
    [MSP430F6638Lib.SCHLIB, Receiver.SchDoc]
2012-05-05 Creado el archivo PCB y linkado con el esquemático (Ojo, posiblemente tengais que ajustar el path de las libs para que os coja el footprint)
    [MSP430F6638Lib.SCHLIB, PCBReceiverProject.PrjPCB, Receiver.PcbDoc, Receiver.SchDoc]
2012-05-05 Implementados dos nuevos dataSources, InputGeneratorSourceThread y RandomGeneratorSourceThread con su Manager correspondiente para hacer pruebas sin el Shimmer. Implementado aplanamiento de ceros en 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
2012-05-05 - Revisados pines del 51 al 100.
    [MSP430F6638Lib.SCHLIB]
2012-05-06 Añadido menú de configuración bluetooth, simple pero funcional. Comenzadas pruebas con el menú de configuración de la visualización (ancho en secs + colores). Comentada (que no limpiada!) Data. Renom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
2012-05-09 - Creado el .sch de la librería del smd de 20 pines, con su footprint encontrado por ahí. - Añadido dos componentes de esos al sch del projecto y al pcb. - Subido también el archivo PCBReceiverProjec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
    [PCBReceiverProject.PrjPCB, Receiver.PcbDoc, Receiver.SchDoc, SMD2x10.SchLib]
2012-05-10 Hecho componente USBLC6-2SC6 Añadida librería de footprints que incluye el CC2012-0805 (SMD) Añadidos D1, R3 y R01 al esqumático
    [MSP430F6638Lib.SCHLIB, PCBReceiverProject.PrjPCB, Receiver.PcbDoc, Receiver.SchDoc, USBLC6-2SC6.SchLib]
2012-05-10 Implementada funcionalidad del botón Ir Atrás. Eliminado botón temporal en menú bluetooth. Eliminados botones sobrantes en la Action Bar. ¿Añadida una línea en blanco al final de Data? (Gracias, Pfer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
2012-05-10 Cambiado menú de bluetooth por un popup mucho más simple. Revertido tema al blanco. Ajustado menú de selección de log. Cambiada pantalla de inicio. Nuevo icono. Microlites just got trendy B|
2012-05-10 Avances en la captura de esquemático.
    [Receiver.PcbDoc, Receiver.SchDoc]
2012-05-11 Añadidos todos los componentes a la placa salvo los pines de expansión. Creadas todas las conexiones en placa (sin verificar aún) excepto las de los pines de expansión (y por extensión las de la radi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
    [MSP430F6638Lib.SCHLIB, PCBReceiverProject.PrjPCB, Receiver.PcbDoc, Receiver.PcbLib, Receiver.SCHLIB, Receiver.SchDoc, SMD2x10.SchLib, Sheet.SchDoc]
2012-05-13 Mapeados pines de la radio al msp. Arreglado fallito en el esquemático. Creado footprint (sin mucho éxito ._.) del conector JTAG que vamos a usar.
    [Receiver.PcbDoc, Receiver.PcbLib, Receiver.SchDoc]
2012-05-13 - Introducidos nuevos capítulos y secciones para ir aclarando la estructura (discutible) de la memoria. - Ahora el documento tiene marcadores y si haces click en alguna línea del índice te lleva a la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
2012-05-14 - Rehecho el Makefile para simplificarlo y hacerlo sencillo y para toda la familia. - Ahora con "\thetitle" y "\thedate" se pueden escribir el título del documento y la fecha de hoy, para no tener qu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
2012-05-14 - Primera versión de la introducción al capítulo de la aplicación Android. Espero que sea del gusto de sus señorías.
2012-05-14 Arreglos en la placa: + Conectado JTAG4 a GND + Conectado AVSS y MSP96 a GND + Cambiado Q2 de 32.x kHz a 4Mhz
    [Receiver.PcbDoc, Receiver.SchDoc]
2012-05-14 Añadidos comentarios con esbozos a intro.tex Renombrado el horrible "rafadixit" por "ideas" y añadidas algunas "ideas"
2012-05-16 Refactorizada Intro con feedback de pimo y jbr
2012-05-16 Añadido C8 al esquemático.
    [Receiver.PcbDoc, Receiver.SchDoc]
2012-05-18 - Escrita primera versión de la introducción del documento. - Escrita primera versión del apartado de "State of the art" de "Android Accessory Development". - Cambiado el tamaño de la fuente a 12pt.
2012-05-18 Comenzada (no terminada) sección de introducción a la sección de desarrollo de software. Actualizado Makefile.
2012-05-19 Repasada y rematada introducción al capítulo de software. Redactados Casos de Uso.
2012-05-19 Añadida nueva sección Análisis de Riesgos al capítulo de Software. Modificada estructura de sección de iteraciones. Detalles menores corregidos en dicho capítulo.
2012-05-20 - Leído y revisado android.tex. - Corregidas un par de erratas en android.tex e intro.tex. - Modificado "all the risks" por "every risk", que me sonaba mejor. - "In most of cases" en android.tex me s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
2012-05-20 - Pequeña introducción para la sección de los objetivos del proyecto. - Completado el objetivo de "Comunicación con 802.15.4". - Completado el objetivo de "Aplicación ECG Android" - Completada la "Do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
2012-05-20 Microavance en sección gestión de riesgos de capítulo software.
2012-05-21 Minicommit con el apartado de 802.15.4 del estado del arte.
2012-05-21 Minicommit con un parrafito de prueba y un par de erratas corregidas, que me echan los lacayos de Gervie.
2012-05-21 - Revisado el último commit sobre la parte de software. - Cambios muy menores (nada de contenido, corregidas un par de erratas y añadido un comentario sobre algo que me sonaba raro).
2012-05-21 - Hecho más o menos el apartado del proyecto de la EPFL del estado del arte.
2012-05-21 En microlites: avances (que no éxitos) en la comunicación con USBLANDIA! En reportland: arreglo de fallo en Softwar.
2012-05-22 - Reorganizada la introducción para que tenga una descripción del proyecto al principio (que acabo de empezar) y que incluya después los objetivos del proyecto.
2012-05-22 +Creada la estructura en secciones y subsecciones que ne princpio contendrá la parte de hardware, tambien he revisado el documento de ideas, y con eso y lo que se me ha ido ocurriendo he ido rellenan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
2012-05-22 Cambiado título del proyecto en la memoria a algo menos tonto que electrolites. Redactados todos los riesgos menos uno y planteado (que no redactadas!) el contenido de todas las iteraciones.
2012-05-22 + Reocolocada la introduccion al principio del capitulo como es natural y añadida una seccion de nombre Description(se aceptan sugerencias de nombres) para hablar de los terminos más importantes del 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
    +Rellenados ambos apartados con todo lo que tenía apuntado que quería/mos meter y alguna cosa que se me ha ido ocurriendo.
2012-05-22 Añadida mención al desarrollo USB host a la iteración 4 del capítulo de software.
2012-05-23 - Revisada la parte de riesgos software. - Reampliada la descripción del proyecto.
2012-05-23 - Añadidas unas cuantas labels (en Software Development) y referencias (en Intro). - Retocada la motivación del proyecto. - Ampliada la parte de Android Accessory Development en State of the art.
2012-05-25 - Añadida la noticia de TI a la bibliografía (aunque habría que formatearla). - Añadido el package url para poder añadir ídems. - Modificado el objetivo de la comunicación con emisores 802.15.4 - Cas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
2012-05-26 Cambiado orden de las secciones SW y HW porque en la de SW se hacen referencia a demasiados conceptos y a las diferentes fases de la investigación HW para motivar las decisiones tomadas. Añadida pequ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
2012-05-26 + Escritas una miniintroduccion para las tecnologias y otra para los hitos
    + Escritos los dos primeros hitos, el de arduino(en el que si quereis meter mano me vendría bien ya que como no hice yo eso hay partes que puedo no conocer).
    Y sobre todo el segundo, el del USB con un tono de batalla epica que aumenta segun te acercas al final de la sección, que me ha quedado que te cagas(con algunas dudas linguisticas que espero no empañen la lectura XD)
2012-05-27 - Añadida la importancia del 802.15.4 por su potencial aplicación a la domótica a la motivación. - Destacado el hecho de que el uso de la capa MAC permite el desarrollo de comunicaciones en tiempo re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
2012-05-27 Redactada Iteración 1 del desarrollo de SW. Añadida tablilla de planificación basada en casos de uso a la sección de planificación SW. Corregidos detallitos.
2012-05-27 - Ahora la descripción del proyecto habla de que hay que hacer un accesorio 802.15.4 compliant para que la cosa funcione, y que esa comunicación es la parte más importante del trabajo. - Lo mismo en 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
2012-05-27 Editada sección de intro del capítulo de HW. Añadido pdf al repo para facil compartición (podemos pasar un enlace público al mismo)
2012-05-27 Editados tres parrafillos de HW.
2012-05-29 Cambios en varias partes de la memoria.
2012-05-31 +Añadidas intros en las milestones, pensada/mirada principio de la introducción
2012-06-02 Añadido comentario para inclusión de info en la intro.
2012-06-02 + Algunos cambios menores en el segundo milestone porque me he dado cuenta que faltaba una mencion tanto al hecho de que la placa era nueva como al famoso reloj de 4MHz.
    + Nuevo milestone desarrollado, USB and FreeRTOS
    + Escritos objetivos iniciales de los milestones que se nos quedaron sin escribir el otro día en el seminario.
2012-06-02 - Corregida la intro con los comentarios que hizo Recas. - Ahora la parte de "Lower power consumption" simplemente indica que Bluetooth consume más (con un ejemplo), redirigiendo al capítulo de HW (h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
2012-06-02 Un par más de párrafos añadidos a la intro siguiendo la línea experimental.
2012-06-02 - Añadida como referencia la página del proyecto de Fran en la EPFL (que tiene todo lo que hace falta referenciar). - Retocada la parte del proyecto de la EPFL, añadiendo la cita a la correspondiente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
2012-06-02 + Añadida otra milestone, es posible que en alguna de las dos últimas(en las primeras lo hay seguro) haya algun cambio de tiempo y persona porque no me sale natural hacer las milestones en impersonal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
    + Arreglados un par de errores, y algunas chorraditas
2012-06-03 Eliminada referencia a entorno de aplicación médico y sustituida por entorno in-home healthcare en la zona de HW. Pequeños arreglos y comentarios en HW.
2012-06-03 + Milestone sobre juntar radio y USB, falta la de "la historia de la semana pasaaaada(y la anterior)" y el resto no se pueden hacer todavía puesto que no las hemos vivido aún.
2012-06-04 Detalles y cosillas añadidas en todas partes. Eso, y ahora mi fondo de Google es un mono.
2012-06-04 Añadida la referencia a la página de soporte de Apple acerca del jailbreak de iOS.
2012-06-05 Redactada parte sobre la aplicación Android de la intro, faltan referencias. Arreglos menores de estilo.
2012-06-05 Descripción de proyecto casi completada, falta una conclusión. Añadido paquete para hacer notas (para nosotros, se entiende) con \todo Añadida Todo List en la segunda página, útil para saber los deta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
2012-06-05 Comenzada (en plan esbozo) la arquitectura de SW, con uml y todo! yay! Añadida imagen de la arch y carpeta para imágenes (que no he conseguido que pille el latex) :| Añadida carpeta uml con el proyec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
2012-06-05 - Corregidas un par de erratas en la intro. - Añadida una label en la sección de HW, y usada en la intro. - Añadidas nuevas entradas en la bibliografía, que se usan para documentar el estado del arte.
2012-06-05 - Refactorizada un poco la scrap zone: ahora se presentan los puntos que el accesorio debe resolver (reutiliza un poco los desafíos que tenía Pferv). - Añadido un párrafo que enlaza la (former) scrap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
2012-06-05 +Hecha una señora introduccion para las milestones que si no me equivoco ocupa más que la milestone mas larga. A mi no me compila así que lo mismo lo he roto y como soy tontito no he sabido arreglarl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
2012-06-05 Arreglado el puto capítulo de hw que estaba roto D:<
2012-06-05 Lo resubo con más arreglos de lo de las etiquetas que estaba mal hecho, pero sigue sin compilar
2012-06-06 Finalizado esbozo de Diseño y Arquitectura de SW. Nuevo diagrama añadido: el Modelo de flujo de datos y su realización. Ahora las imágenes se cogen de la carpeta figs.
2012-06-06 - Completados los issues del hardware para apañar la scrap zone. - Hecha la parte de Technology Research (le he cambiado el nombre porque me sonaba mejor) de Arduino.
2012-06-06 Avances significativos en la arquitectura SW Cambiado archivo android.tex a software.tex
2012-06-06 - Corregidas un par de erratillas en software.tex (que por lo que veo, ya habían sido subsanadas en su mayoría). - Adaptada la introducción de las milestones/planificación de HW.
2012-06-06 - Pequeños cambios en hardware y software. - Revisados los apartados 3.6.1 y 3.6.2 de software.tex.
2012-06-07 Finalizada arquitectura de SW de forma provisional (faltaría una sección con cosas como diagramas de secuencia) Nuevas imágenes, yay! Microarreglillos en HW.
2012-06-07 Actualizo tambien la parte de uml por si queréis tocar algo.
2012-06-07 - Añadido el tipo específico (B) del usb que usa arduino. - Hecha la parte de MSP430 (thoroughly documentadito) de las tecnologías investigadas a falta de ampliarlo con lo que hizo Pferv yesterday.
2012-06-07 Comiteo de una vez lo de hardware que creia haber comiteado ayer, como me ha conlictado al bajarmelo el hardware y miguel ha dicho que luego juntaba las dos partes del MSP las he subido una detras de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
2012-06-07 Escritas todas las iteraciones (que han sucedido) del proyecto de SW. Minor fixes in SW chapter.
2012-06-07 - Mergeada la parte de MSP430 de las tecnologías investigadas con lo de Pferv (lo suyo lo dejo comentado JIC).
2012-06-07 IGr, Cathálan - Refactorizado y completado el hito de Arduino.
2012-06-07 +Planteada conclusion del hardware, en español pero descomentada por petición de rafa.
2012-06-07 + Planteada conclusión del documento, hay que hablarla pero al menos ya hay ideas sobre las que hablar
2012-06-08 Revisados los cambios en software.tex hasta la iteración 3 inclusive.
2012-06-08 Ordenadas los parrafos(y añadido alguno) de las milestones dentro de los objetivos que epxlica cada una para mayor facilidad de traducción para el que le toque.
2012-06-08 Escrita última iteración SW. Añadida información sobre eǘolucioń de los rieśgos a las iteraciones.
2012-06-10 - Completada la mileston del MSP430 con el párrafo de conclusión. - Traducidos los dos primeros objetivos de la milestone "USB & FreeRTOS".s
2012-06-11 Traducidos los dos últimos objetivos de la milestone de USB en FreeRTOS y añadida una introducción.
2012-06-11 - Conclusión de la milestone de USB in FreeRTOS. - Sección de USB host vs device.
2012-06-11 Redactada primera versión de la conclusión SW. Arreglos menores en capítulo SW. Transcrita milestone HW 2.5.4 completa y primer párrafo de la siguiente. Arreglos menores en capíutlo HW.
2012-06-12 Terminada milestone 802.15.4 + USB y comenzada la del PCB.
2012-06-13 Terminada milestone HW del PCB hasta donde se puede. Revisadas milestones anteriores.
2012-06-13 - Corregidas un par de cosas de la milestone de USB en FreeRTOS. - Especificada la responsabilidad del host de crear la conexión en USB host. - Detallitos menores en otras milestones. - Eliminados lo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
2012-06-13 - Añadidos todos para los apartados que faltan por rellenar, para tenerlos mas a mano en la lista de la segunda página
2012-06-13 Hecho el apartado de Shimmer de las tecnologías investigadas.
2012-06-16 Actualizada 1.1. con notas de Recas. Rematada 1.2 (motivación). Replanteada 1.4 (overview) con el detalle que pedía Luis hasta sección HW incluída. Faltan SW y Conclusiones. Detallitos arreglados aqu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
2012-06-16 - Cambiadas las referencias de la intro de "soft real-time" a "real-time". - Revisado el apartado de Shimmer. - Comenzado el apartado de 802.15.4, falta la parte del menor consumo de potencia (y una 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
2012-06-16 Sección SW revisada, arreglada y, a falta de citas correcatas, completada :)
2012-06-16 - Añadido Precas a la bibliografía! - Ampliado y mejorado el apartado de 802.15.4
2012-06-17 Citas añadidas a la intro.
2012-06-17 Referencias del capítulo de SW puestas.
2012-06-17 - Corregidas erratillas de la conclusión HW. - Escrito todo lo que se puede (y se me ha ocurrido) de FreeRTOS, sin referenciar nada todavía.
2012-06-18 - Reorganizados las entradas de la bibliografía para que vayan en orden. - Incluidas referencias necesarias en la introducción y arregladas algunas inconsistencias. - Apañada la especificación del cu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
2012-06-18 Pequeños cambios en microlites en pos de un buen debuggeo
2012-06-18 Terminada la traducción de la descripción del proyecto para el resumen en español. Arreglados dos detallitos en la intro.
2012-06-18 - Esbozada la portada. - Comentada la lista de todos para ver cómo queda. - 100 págs! Yay! Qué pesaos somos!
2012-06-19 Cambios en la portada (nombres que se juntan rarunamente) Avances significativos en los resultados. Arreglillos en la intro y en el HW.
2012-06-19 Añadida la parte de la motivación del proyecto al resumen en español.
2012-06-19 Hecha la primera versión de las ampliaciones potenciales.
2012-06-19 Corregidas un par de "idas de dedos" en el resumen en español.
2012-06-19 Correcciones y pequeñas mejoras a las tecnologías de 802.15.4 y FreeRTOS. Waiting for Recas' explanations.
2012-06-19 + Añadido el project bastante avanzado ya.
2012-06-20 No soy Rafa, así que no sé qué cosas han cambiado. - Portada semi-oficial.
2012-06-20 - Alguna corrección en los resultados. - Terminada la parte de posibles ampliaciones en español.
2012-06-20 +Actualizado a un estado mucho más final +Añadida la imagen del gant a modo de placeholder porque hay que arreglarla +Añadida la lista de tareas también +Añadida tabla/apartado con los costes del pro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
2012-06-20 - Commiteo el resultado del rutado (parcial) de CRoa + myself. - Es probable que esto no sea lo mejor
    [MELF - Diode.PcbLib, PCBReceiverProject.PrjPCB, Receiver.PcbDoc, Receiver.PcbLib, Receiver.SCHLIB, Receiver.SchDoc]
2012-06-21 Actualizado el rutado del PCB (versión inexperta)
    [Receiver.PcbDoc]
2012-06-21 Terminadas conclusiones del doc. Casi casi terminado el resumen en español. Arreglado el gantt para que no de asco infinito.
2012-06-21 SI, Croa - Primera versión final del PCB.
    .
    ❤❤ BY MICCHÁN ❤❤
    [PCBReceiverProject.PrjPCB, Receiver.PcbDoc]
2012-06-21 Añadida tabla con el coste de producción de una unidad
2012-06-21 Arreglados costes de producir uno que tenian varios fallos
    Añadidos costes de producir 10.000
2012-06-21 Escritas dos miserables líneas de intro al anexo ingenieril. Cambiado un 2 por un especialmente significativo 20000.
2012-06-21 - Correcciones menores en los findings. - Apañadas las secciones de 802.15.4 y FreeRTOS con las indicaciones de JRecas.
2012-06-21 Hecho el apartado del rutado PCB en la última (penúltima) milestone.
2012-06-22 - Conclusión de la milestone de PCB. - Milestone (chiquitica) de Final Validation.
2012-06-22 - Revisada la conclusión en español. - Retocada la milestone de validación final.
2012-06-22 Actualizado Gantt. Escrito Abstract en español y en inglés. Actualizada cesión de derechos.
2012-06-22 Revisado lo que va de anexo ingenieril.
2012-06-22 Cambios(, cambios que por pequeños que sean,) en engineering, añadida la BOM
2012-06-22 añadido PCB renderizado en 3D que mola
2012-06-22 Y ahora subo la imagen de verdad
2012-06-22 Me duele, y mucho, la puta cabeza.
2012-06-22 +Añadidos otras dos imagenes del PCB
2012-06-22 Release Candidate 1 de la memoria
2012-06-26 Añadido Microlites-lite (sólo carpeta, me temo). Cosas de memoria.
2012-06-26 COMMIT POTENCIALMENTE CONFLICTIVO!
    microlites-lite!
    [proguard.cfg]
2012-06-26 - Terminadas las correcciones de Recas. - Actualizado el coste del prototipo y del proyecto con los dineros que nos ha dicho Croa.
2012-06-26 - Comenzada la ultimate review de la memoria. - Revisado y corregido hasta el SotA (no inclusive).
2012-06-26 Revisadas Hardware, Results y anexos. Cambios menores, cabeceras de tablas de anexos en negrita.
2012-06-28 Ahora se resetea la vista cada vez que se abre una nueva.
2012-06-28 Arreglos en microlites-lite para que sea una app de verdad y bien.
2012-07-01 Arreglados mil detallitos de microlites porque soy un badass. -Rafa
2012-07-01 +Lo que estuvo haciendo rafa el otro día, el boton de cancelar del bluetooth y quitar lo de pausar la vista
2012-07-02 Más cosas que molan en MICROLITES!
2012-07-06 Comentado un mensaje de error de Bluetooth que fallaba.
